jphacks/tkb_2618/docs/HANDOFF.md

# 引き継ぎ（2026-10-27 時点）

決めたこと・終わったこと・次にやることのまとめ。正はコード（main）で、ここと食い違ったらコードに合わせて直す。新しいセッションで作業を再開するときは、まずこれを読む。

## 進め方

- **Claude は PM と視覚の制作（UI デザイン、動画、図）の担当。** 仕様とタスク書を書き、単純な実装は Codex CLI に任せ、終わったら差分を確認する（ユーザー指示「あなたはPM 使うべきはcodex」「視覚などの創作タスク+PMはclaude 単純なコーディングはcodex」2026-10-26）
- Codex は `AGENTS.md` と `docs/tasks/NN-*.md` を読んで実装する
- コミット・プッシュは PM（Claude）がレビューしてから。ブランチは issue ごとに `main` から切り、`yub4-arema-<issue 番号>-<内容>` と名付ける（issue のない作業は `yub4-arema-<内容>`）。issue ごとのブランチは 2026-10-26 に決めた。main へのマージはユーザーが行う（リモート `jphacks/tkb_2618`）。**`jphacks/tkb_2628` は別チームのリポジトリなので触らない**
- ユーザーは質問を歓迎（「聞きたい内容があったらどんどん質問して」）。UI 文言は日本語
- 完成したら、ユーザーが元の Windows PC に移してハードをつないで確かめる。その手順の細部は PM に任されている → `docs/hardware-test.md`

## ハードで決まったこと（ユーザー決定、2026-10-24）

- 回路の正はチームの回路図 `docs/circuit.html`（元: https://claude.ai/artifact/SdUvAXonEdvWRYHbBbfajF ）。**回路は変えない。部品は買い足さない（購入済み）**
- XIAO ESP32S3、ピエゾ 7BB-27-4L0 ×4、NJU7043D ×2（ボルテージフォロワ）、ダイオードは小信号ショットキー **1SS106**
- ADC は D0 / D1 / D3 / D4（GPIO1 / 2 / 4 / 5）＝ 左上 / 右上 / 左下 / 右下。D2（GPIO3）はストラッピングピンなので使わない
- **本番のファームはチームの `firmware/xiao-stream/`**（2026-10-24 に remote の main へ入った）。判定はせず 4 ch の生値を毎秒 4000 行送るだけで、判定はアプリ（2026-10-24 のチームの決定）。`firmware/` のほかは参考実装。機能は変えない。xiao-stream は Arduino IDE で書き込み、PM は触らない
- アプリの判定は参考実装の `Detector` を TS に移したもの
- **任意のテーブルで成り立たせる**（特定の机・板に合わせ込まない）。テーブルごとの違いはキャリブレーション（ソフト）で吸収する

## いまの状態

| タスク | 状態 |
|---|---|
| 01 土台と画面 | ✅ PM が画面で確認済み（WSLg + CDP。寸法・角の線・端の点・光る演出・歯車パネル・ドラッグ・モックでのキャリブレーション完走） |
| 02 アクション・トレイ・通知 | ✅ 実装済み。Windows API は WSL で動かせないので、Windows での確認は `docs/hardware-test.md` 2 章 |
| 03 シリアル・キャリブレーション | ✅ 実装済み。Duplex テストで接続〜再接続を確認 |
| 04 ファームウェア | ✅ `pio run` / native テスト通過 |
| 05 hotkey を物理キーで記録（JIS） | ✅ `KeyboardEvent.code` で記録し、Set 1 スキャンコード（`KEYEVENTF_SCANCODE`）で送る。旧形式の移行、`npmRebuild: false`。test 14 件通過 |
| 06 XIAO 対応 | ✅ `xiao_esp32s3` env（USB CDC）。この書の回路の節は PM の誤りで、08 が正 |
| 07 任意のテーブル（プロトコル v1.1） | ✅ 学習した型での領域判定、`ring` → `refractoryMs`、飽和打の棄却。app test 21 件・native 30 件通過。モックでキャリブレーション完走・保存を画面で確認（飽和のモック打は数えない） |
| 08 ファームを正式な回路に合わせる | ✅ ピン 1/2/4/5、`raw` モード、`sat`（FW-007）、README を回路図どおりに。ビルド 3 env・native 27 件通過 |
| 10 本番ファーム xiao-stream に対応 | ✅ 検出器を TS に移植（`protocols/detector.ts`、参考実装の native テスト 24 件を同じ期待値で移植）。`xiao-stream` アダプタ（命令は手元で処理、校正値は `Config.calibration` に保存）、`protocol: 'auto'` で形式を自動判別。24 万行を 2〜3 バイトに割って流して 16 種類の tap と飽和を確認（約 0.3 秒）。test 59 件通過。`tests/fixtures/*.log` がルートの `*.log` で無視されて 09 のコミットに入っていなかったのも直した |
| 09 ファームの形式を差し替え可能に | ✅ シリアルの形式を `app/src/main/protocols/` のアダプタに分離（既定 `deskapi-v1`）。校正非対応のファームではボタンを無効化。ログを流し込むテスト、`npm run serial-log`。test 26 件通過 |
| 11 叩き方ごとの生値を集める CLI | ✅ `tools/tap-collect/collect.mjs`。叩き方を指示 → 開発者が叩く → ラベル付きで `raw.csv` / `trials.jsonl` に残す。（試行数と時間は 13 と 16 で変わった。今は `tools/tap-collect/README.md`）。`--mock`・`--resume`・違うファームの警告。PM が疑似端末で通しを確認 |
| 12 ログで検出器を採点する | ✅ `tools/tap-collect/score.mjs`。`app` と takker 版（`--takker <sensor-runtime>`）を同じ物差しで採点。キャリブレーション用と採点用のログを分ける（今は `--session` と `--calibrate A --test B`）。合成データの CV で app 87.5%・takker 43.8%（合成なので意味はない）。test 17 件通過 |
| 13 記録をキャリブレーション → 使用の 2 部に・5 分 | ✅ アプリと同じ手順のキャリブレーションの部（単打 8×3、2 回叩き 4×2）＋使用の部（16×3＋叩き以外 4）。自動で進む（`r` / Space / `n` / `q`）。（16 で強弱をなくし、今は 21 試行・約 2 分 17 秒）。採点は `--session` / `--calibrate A --test B`、`score.md` の先頭にキャリブレーションの診断。PM が疑似端末で確認。test 20 件通過 |
| 15 キャリブレーションの誤カウント・未接続ポップアップ | ✅ ユーザー指示で今回は Claude が実装（タスク書なし、`docs/spec.md` に反映）。**キャリブレーションを tools/tap-collect と同じ手順に作り替え**（指示 → 1 秒静止で基準値 → 合図 → 5 秒の区間だけ記録、静止のピーク × 1.5・50 ms の間で打を数える。自動では拾わない。`app/src/main/recorder.ts`）、強だけやり直し＋理由の表示、エラーを画面に出す、未接続ポップアップと理由（no-port / busy / no-response）、2 秒無通信で切断、**ポートを閉じずに `destroy()` していて再接続できなかったのを修正**、モックの校正値を保存しない。test 63 件通過。実機ログ（`tap-logs/20261025-015737`）を新しい数え方で再生すると各ステップ 0〜3 打しか拾えない＝信号が小さい（D1・D3・D4 の静止値が約 3250 で中点 1.65 V からずれている。テスターなし）。実機（COM5）で接続・ポート切り替え後の再接続・抜いたときのポップアップを確認 |
| 16 強弱の削除（8 キー） | ✅ 2026-10-25 のユーザー指示で Claude が実装（アプリ・デザイン・仕様）、tap-collect は Codex（`docs/tasks/16-no-strength-tap-collect.md`）。キー = 領域 × 1 回 / 2 回、`keyIndex = region*2 + count-1`。設定 `version: 2`、v1 は `upgradeConfig` で弱のキーを残して 8 キーに（弱が空なら強）。キャリブレーションは 4 段 × 3 打。しきい値は ch ごと（その ch が一番鳴った打の最小 × 0.5 と静止ピーク × 2 の大きい方）。山の係数 1.5 は実ログ 6 セッションで比較して据え置き（1.25 は誤検出が出る。4 ch のエネルギー合算も劣る）。参考ファームには `strongMin` 4095 をアダプタが補う。`DESKAPI_USER_DATA` で設定の置き場所を変えられる（モックのランダム打は本物のアクションを動かすため）。app test 65、tap-collect test 31＋skip 1。追記: 検出器の DC を最初の 1 サンプルで決めていたため、接続直後に途中で切れた行（3301 が 301 など）が来ると叩き続けの誤検出が止まらなかった（`tap-logs/20261025-045135`）。最初の 8 サンプルは判定せず、ずれた ch は中央値で置き直す。run モードで 2 秒しきい値を超え続けた ch は DC を置き直す。CLI の 2 回の指示を「ダブルタップ（トントンと素早く 2 回）」に（Codex）。指示を直したあとの 2 回叩きの間隔は 220〜340 ms で、待ち時間 320〜500 ms は点が同じなので 320 のまま。接触不良修理後のログ（`044350` で校正）: 完全一致 `045358` 75%、`044627` 37.5%、`045135` 25%。左下は校正で 3 打そろわないことが多い（センサーが遠い）|
| どの領域にも似ていない打を捨てる | ✅ 型があるとき、信頼度 0.3 未満の打はキーを動かさない（`detector.ts` の `MIN_CONFIDENCE`。実ログで領域違いは全部 0.3 未満、正解は 0.5 以上）。初期プロファイル「作業」をデモ用のアプリ起動 8 個に（デザインも同じ）|
| キャリブレーションの進め方（ユーザー決定 2026-10-25） | **tap-collect でキャリブレーションを最適化 → 本番（アプリ）に採用**。tap-collect の改修は Codex が行い、Claude は tap-collect に手を入れない。アプリの手順は collect.mjs に合わせる（指示から合図まで 2 秒、静止のピークは collect の定義）。採用する場所は `app/src/shared/tap-procedure.ts`（score.mjs の app アダプタが `main/recorder.ts` 経由で同じコードを採点に使う）。2 回叩きは最適化しない（ユーザー決定）ので、アプリのキャリブレーションに 2 回叩きのステップは入れない |
| 17 キーの色をスライドのパレットに | ✅ Codex が実装、PM が直した（PR #18。旧 id を `'gr' + 'een'` と分けて完了条件の検索をすり抜けていたのを、`validation.ts` の `RETIRED_COLORS` に）。test 70 件通過。キャリブレーションの波紋は、タイルの外へ広がるので白のまま |
| 審査の提出物（2026-10-26 08:00 締め切り） | ✅ README を初回コミットのテンプレートどおりに書き直し（項目 7 なし、精度の数字なし）。デモ動画と README 画像の Remotion ソースは `video/` に収録する（ユーザー許可 2026-10-26）。ロックファイル・ロゴ・使用中の 1080p 実機素材を含み、別 PC でも再生成できる。完成動画・未使用の元映像・node_modules は収録しない。手順は `video/README.md`。動画には発表動画と同じ説明（困りごと・仕組み）を入れず、実機の映像と設定画面を見せる（ユーザー決定 2026-10-26）。`demo.jpg` は実機の映像の 1.47 秒。タグ `hackday-code-freeze` = 42569d5。動画は YouTube に公開済み（https://youtu.be/Rw6g0IRwGyE）|
| 14 叩き以外の動作を増やす | 構想のみ（後回し）。PC を置く・マウス・ペンなど 11 種類と自分で足せる種類、叩き以外だけを撮るセッション（`--disturbances`、約 2 分半）、種類ごとの誤検出の採点。タスク書あり |

README（2026-10-27）: 精度の節は 2026-10-25 の採点（`044350` で校正、3 回分）の良い面を載せる。無線（Wi-Fi・BLE）は動いているが main にファームがないので、README では今後の展望に置く。

## 開発環境のメモ

新しい PC（Windows）での準備は `docs/setup.md`。2026-10-25 の時点で開発は Windows（実機は COM5）で直接行っている。`xiao-stream` の速度テストは、Windows では 1.1 秒かかって 1 秒の上限を超えることがある。以下は WSL で開発していたときのメモ。

- Codex は `codex exec -s workspace-write -C . "..." < /dev/null` で起動する（v0.163 には `--full-auto` がない。`< /dev/null` がないと stdin を待って止まることがある）。サンドボックスはネットワークなし → 依存は PM が先に `npm install` しておく
- firmware は `--add-dir /home/tsuch/.platformio` を付ける。`pio` は `uv tool install platformio` で `/home/tsuch/.local/bin/pio`、ツールチェーンはダウンロード済み
- npm がインストールスクリプトを止めるので、Electron 本体は `node node_modules/electron/install.js` で入れる
- 画面確認: `DISPLAY=:0 DESKAPI_MOCK=1 npx electron-vite dev --remoteDebuggingPort 9222` で起動し、CDP（`Page.captureScreenshot`、`Input.dispatchMouseEvent`）で撮影・操作する。WSL には日本語フォントがないので文字は豆腐になる
- `.orca/` はユーザーの資料置き場（領収書など個人情報を含む）。`.gitignore` 済み。コミットしない

## デザインで決まったこと（ユーザーの好み）

- 方向性は **フラットなミニマル（案 B 机マップ）**。影・グラデーション・木目やマットなどの質感は入れない。「AI slop」と言われた装飾的な案、ガラス案は不採用
- 文字は、アイコンだけでは分からないところにだけ付ける。例: アクション種別の選択肢には短いラベルを付けるが、割り当て後のキーには付けない。プロファイル名は文字。説明文・常識的な文言は書かない
- キーは Stream Deck アプリ風に、左上と右下に L 字の角の線（アイコン色、不透明度 60%）
- 机マップは領域ごとに横 2 キー（1 回 / 2 回）。上端に回数の点（1 個 / 2 個）。文字ラベルはない
- キーの色は発表スライドと同じパレット: 赤 #D12052、橙 #F45B26、黄 #F8DE22、水色 #03AED2、紺 #3C3781。紺以外の上ではアイコンを黒 #121212 にする（2026-10-26 に Adobe Color のパレットから変更。保存済みの旧 id `green` / `blue` は読み込み時に `orange` / `cyan` に直す）
- 背景 #121212、右パネル #1A1A1A
- 設定画面が開いているときは、叩かれたキーを光らせる。閉じているときは Windows 通知
- ドラッグでキーの入れ替えとアクションの割り当て
- メイン UI にシミュレータは入れない。開発者用のデバッグ / ログツールはあとで別画面として作る
- キャリブレーション画面のガラス風装飾はユーザーが「まだ」と保留

デザインの作業キャンバス（全案入り）: https://claude.ai/artifact/63JDGGvWX3fVYajsQuNvty

## 技術の前提

- Windows 専用。Electron + electron-vite + React 19 + Tailwind v4 + @dnd-kit/core。キー入力は koffi（user32 `SendInput`）、マイクは常駐 PowerShell（Core Audio）、シリアルは serialport
- `koffi` と `serialport` は OS ごとに別バイナリ。Windows では必ず `npm ci` し直す（`node_modules` をコピーしない）
- Notion は使わない

## 仕様で PM が決め、コードに入っていること

- ウィンドウを閉じているときは、発火のたびに Windows 通知を出す（歯車パネルでオフにできる）
- ロック中は、ロックアクションのキーだけ反応する（タップで解除できるように）
- 歯車パネルは「通知」「自動起動」「ポート」の 3 項目
- 飽和した打（FW-007、±1.4 V 超え）はアプリが無視する（アクションを実行しない、キャリブレーションで数えない）
- 任意のテーブル対応として、領域判定をキャリブレーションで学んだ型（4 ch の出方）で行い、余韻の長さから `refractoryMs` を決める（protocol v1.1）
- Windows のモック（`DESKAPI_MOCK=1`）は 4 秒ごとにアクションを本当に実行するので、実機確認ではテスト実行ボタンを使う
