jphacks/tkb_2618/docs/tasks/13-calibration-phase.md

# 13 記録をアプリと同じ「キャリブレーション → 使用」の 2 部にする

`tools/tap-collect/` だけ。`app/` と `firmware/` には触らない。

## 背景

11 / 12 では、シャッフルして叩いた試行の一部をキャリブレーションの代わりに使っていた。実際のアプリは「キャリブレーション画面で 1 種類ずつまとめて叩く → その結果で基準を決める → 使う」なので、これでは**キャリブレーションの仕組みそのものに問題がないか**を確かめられない。

そこで 1 セッションを、アプリと同じ 2 部に分ける。

1. **キャリブレーションの部**: アプリのキャリブレーション画面と同じ手順で叩く
2. **使用の部**: いまと同じ、16 パターンと叩き以外をシャッフルして叩く

採点は「1 だけでキャリブレーション → 2 だけで採点」にする。点数が悪いとき、キャリブレーションの段階で失敗したのか、使う段階で外れたのかを分けて見られるようにする。

デモで使う机は決まっているので、同じ机で何度も記録して調整する使い方が主になる。

**1 セッションは合計 5 分以内**（ユーザー指定）。長い 1 回より、5 分のセッションを何度も撮って合算する（採点は複数セッションを合算できる）。

## 時間の配分（既定）

| 部 | 中身 | 時間 |
|---|---|---|
| キャリブレーション | 静止（待ち 2 秒 ＋ 3 秒）＋ 1 回叩き 8 区間 × 7 秒 ＋ 2 回叩き 4 区間 × 7 秒 | 1 分 29 秒 |
| 使用 | 16 パターン × 1 回 × 7 秒 ＋ 叩き以外 4 試行 × 5 秒 | 2 分 12 秒 |
| 合計 | | **3 分 41 秒（33 試行）** |

そのために、試行の進め方を変える。

- **Enter を待たずに自動で次へ進む**。区間が終わったら結果を 1 行で出し（ch ごとの最大のずれ。確認用の山の数は校正用の打撃記録だけ）、すぐに次の指示を出す
- 次の指示を出してから合図まで 2 秒（そのうち合図前 1 秒が記録範囲＝基準値の区間）。`--prepare` で 1 秒以上に変更可能。カウントダウンは出さず、`[14/33] 次: 右上 2回 強` → `叩いて` の 2 段にする。合図は各試行で 1 回だけ表示し、進捗行に合図・指示を重複させない
- 使用の部の区間は 5 秒（3 回叩きは 6 秒）。校正用の打撃区間も 5 秒。叩き以外は 3 秒
- キー（どのタイミングでも効く）:
  - `r`: 直前に終わった試行を `redo` にして、次に撮り直す（記録中に押したら、いま記録中の試行を `redo` にして撮り直す）
  - `n`: 直前の試行にメモを付ける（入力中は一時停止）
  - `Space`: 一時停止 / 再開（手を休めるとき。一時停止中の試行は `aborted` にして、再開後に撮り直す）
  - `q` / Ctrl+C: 終了（いまと同じく保存して終わる。`--resume` で続きから）
- `--reps` の既定を 1 に、叩き以外は各 1 回に、`--window` の既定を 5 秒にする。`--resume` は元の試行と時間を引き継ぐ（`prepare` がない旧セッションは待ち 1.5 秒）
- 終わったら、かかった時間を出す

## 1. tap-collect: キャリブレーションの部

セッションの最初に、次の順で撮る（シャッフルしない。`--order` は使用の部にだけ効く）。

| 順 | kind | 指示 | 長さ |
|---|---|---|---|
| 1 | `calibration` | 机に触れず静止する（いまと同じ） | 3 秒 |
| 2〜9 | `cal_single` | 「左上・弱 を 3 回、ゆっくり叩く」。左上弱 → 左上強 → 右上弱 → 右上強 → 左下弱 → 左下強 → 右下弱 → 右下強（アプリのキャリブレーション画面と同じ順） | 5 秒 |
| 10〜13 | `cal_double` | 「左上 を 2 回叩きで 2 セット」。左上 → 右上 → 左下 → 右下。強さは問わない（2 回叩きの間隔を測るためなので） | 5 秒 |

- `--strengths` / `--zones` に合わせて、出てこない領域・強さは撮らない（`medium` を足したら `cal_single` にも入る）。`--counts` に 2 がなければ `cal_double` は撮らない。3 回叩きは使用の部だけ
- 記録中の表示・キー・ファイルへの残し方は、使用の部と同じ。`trials.jsonl` には `phase: "calibration"`、`zone`、`strength`（`cal_double` は `null`）、`count`（`cal_single` は 1、`cal_double` は 2）、`sets`（`cal_single` は 3、`cal_double` は 2）を入れる
- 撮り終えたら、その場で「ch ごとの最大のずれ」を出す。校正用の打撃記録（`cal_single` / `cal_double`）では、合図前 1 秒の中央値からのずれが ch ごとの「静止」の最大のずれ × 1.5 を超えた波を `山 3` のように出し、その場で打撃を拾えているか確認できるようにする。波は 50 ms を超える静かな間隔で区切る。静止の測定・使用の部では山を判定・表示しない。この数え方は確認表示のためだけで、検出器の校正・採点には使わない。使用の部は後から `score.mjs` で校正済みの検出器に流して採点する。旧ログ（× 3）とは直接比較しない。
- 使用の部の試行は `phase: "use"`。いまの試行と同じ
- `README.md`（ログの形式の説明）に、2 部構成と新しい項目を書き足す

### 合成データ（`--mock`）

`cal_single` は合図の 0.4 秒後から約 1.4 秒（±0.3 秒）おきに 3 回、`cal_double` は約 2.2 秒おきに 2 回叩きを 2 セット。1 回ずつの振幅・重みのばらつきは 12 の修正と同じ。

## 2. 採点: キャリブレーションの部でキャリブレーションし、使用の部で採点する

```
node score.mjs --detector app --session tap-logs/A                     # A のキャリブレーションの部 → A の使用の部
node score.mjs --detector app --calibrate tap-logs/A --test tap-logs/B  # A のキャリブレーションの部 → B の使用の部
```

- `--session <dir>…`: セッションごとに、そのセッションのキャリブレーションの部でキャリブレーションし、同じセッションの使用の部で採点する。複数なら合算する
- `--calibrate <dir> --test <dir>…`: センサーを貼り直したあとのログなどで確かめるため
- `--cv` と `--train` はなくす（キャリブレーションの部があるので要らない）。キャリブレーションの部がないログを渡したら、そう分かるエラーにする

### 検出器のキャリブレーション

- `app`: `calibration` でノイズを測り、校正用の打撃を探すしきい値を記録した静止ピーク × 1.5（最低 1）にする（固定 150 は使わない）。アプリの記録処理（`recorder.ts` の `MountainCounter`）で `cal_single` の各区間の合図前の中央値を基準に `hit` を集め、設定画面と同じく飽和していない山のうち振幅が大きいものから領域×強さごとに 3 つずつ `calculateCalibration` に渡す。3 つに足りなければ、どれが何個だったかを書いて 0 点。使用の部は計算した校正値で `Detector` に流して判定する。校正用のしきい値は `calibrationThresholds` に保存する
- `takker`: `cal_single` の区間で出た `tap` から `features` を作り、`TARGETS` ごとに `REQUIRED` 個。足りなければ同様
- `cal_double` は、どちらの検出器のキャリブレーションにもいまは使わない（検出器の作りを変えないため）。代わりに下の「キャリブレーションの部の診断」で測る

### キャリブレーションの部の診断（`score.md` の最初の表）

キャリブレーションの仕組みに問題がないかを見るための表。採点の点数より前に出す。

| 項目 | 中身 |
|---|---|
| 区間ごとの検出数 | `cal_single` / `cal_double` の区間ごとに、検出器が見つけた打（`app` は `hit`、`takker` は `tap`）の数。期待は `cal_single` 3、`cal_double` 4。ずれている区間に印 |
| 飽和 | 飽和で数えなかった打の数 |
| キャリブレーションの結果 | 決まった値（`app` は閾値・強弱の境目・型・`refractoryMs`・`doubleWindowMs`、`takker` は覚えた特徴の中心とばらつき） |
| 強弱の分かれ方 | 領域ごとに、弱 3 回と強 3 回の振幅の最小〜最大。重なっていたら印 |
| 2 回叩きの間隔 | `cal_double` で測った 1 回目と 2 回目の間隔（ms）の最小・平均・最大と、検出器の 2 回目の待ち時間（`app` の `doubleWindowMs`、`takker` の `doubleMs`）。最大が待ち時間を超えていたら印 |

そのあとに、いまと同じ使用の部の点数（完全一致・強さを無視した一致・領域 / 回数 / 強さ・余計・叩き以外・試行外・混同行列）を出す。

## テスト

- 11 / 12 のテストを 2 部構成に合わせて直す
- 並び: キャリブレーションの部が先頭に固定の順で並び、`--seed` は使用の部の並びだけを変える。既定で 1 + 8 + 4 + 16 + 4 = 33 試行
- 時間: 既定の並びで、記録の区間と合図までの間の合計が 5 分以内（操作の待ちは含めない計算で、時計を差し替えて確かめる）
- 自動で進む: キー入力なしで最後まで進む。`r`（直前・記録中）、`Space`（一時停止 → `aborted` → 撮り直し）、`n` が仕様どおり
- 診断: 合成の打の一覧から、区間ごとの検出数・強弱の重なり・2 回叩きの間隔が期待どおり数えられる
- `--mock` 相当のセッションで `--session` の採点が `app` と `takker` の両方で 0 点より大きい（takker は `TAKKER_RUNTIME` があるときだけ）
- キャリブレーションの部がないログでエラー

## 完了条件

- `npm test`、`TAKKER_RUNTIME=/tmp/takker-runtime/mockui/sensor-runtime npm test` が通る
- 完了報告に、`--mock` 相当のセッションでの `app` / `takker` の `score.md` の 1 行目と、診断の表の例
- `docs/hardware-test.md` の tap-collect の節を 2 部構成・自動で進む形に合わせて直す（1 セッション約 5 分、何度も撮って `--session A B C` で合算すること）
- 完了報告に、既定の 1 セッションの計算上の所要時間と `raw.csv` の大きさ

## PM レビューでの修正

1. **キーボードを打つ試行で、打ったキーが操作になる**: `typing` の記録中に打った `q` / `r` / Space / `n` が、終了・撮り直し・一時停止・メモとして効いてしまう。キーボードを使う試行（いまは `typing`。今後キーボードやマウスを使う種類が増える）の**記録中は、Ctrl+C 以外のキーをすべて無視する**（`events.jsonl` に `key` としては残さない。打った内容を残さないため）。その試行の指示文に「（このウィンドウで打って大丈夫）」を足す。記録が終わったら、いつもどおりキーが効く。テストを足す
