jphacks/tkb_2618/(commit log)

2026-10-24 Add xiao-stream firmware (XIAO ESP32S3, 4ch ADC streaming)
2026-10-25 yub4-aremaのコードを採用した (#1)
    * DeskAPI: 仕様・デザイン・Codex タスク書と実装の途中経過
    - AGENTS.md, docs/spec.md, docs/protocol.md, docs/tasks/01-04
    - docs/design: 承認済みの設定画面・キャリブレーション画面
    - app/: Electron + React の土台と画面（タスク 01 途中、メモリ不足で中断）
    - firmware/: ESP32 ファームウェア（タスク 04 途中、メモリ不足で中断）
    * 引き継ぎ資料（docs/HANDOFF.md）と CLAUDE.md を追加
    * DeskAPI: アプリ・ファームを実機確認できる状態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
2026-10-25 キーの色を発表スライドのパレットにそろえる (#18)
    * キーの色を発表スライドのパレットにそろえる
    赤 #D12052、橙 #F45B26、黄 #F8DE22、水色 #03AED2、紺 #3C3781 の 5 色にする。
    紺以外の上ではアイコンを黒にする。画面のアクセント色（ロック・エラー・
    キャリブレーションの叩く領域・トグル）も同じパレットの色にする。
    色の id は green → orange、blue → cyan に変え、保存済みの設定は読み込み時に
    新しい id に直す。
    * キャリブレーションの波紋を白に戻す
    波紋はタイルの外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
2026-10-25 README を実装に合わせて書き直す (#20)
    * README を実装に合わせて書き直す
    初回コミットのテンプレートの見出しに沿って、製品の説明・仕組み・操作の種類・
    使った技術・独自技術を、いまの実装のとおりに書く。画像はデモ動画と同じ場面から
    書き出したもの。
    * README から動画のソースの記述を外し、Webhook の説明を実装に合わせる
    デモ動画のソースは作品の本体ではないので、リポジトリに入れない。
    Webhook が送るのは叩いた場所・回数・時刻の JSON で、Slack の形式では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
2026-10-25 引き継ぎ書類を更新する (#21)
    * 役割分担に、視覚の制作は Claude が行うことを書く
    UI デザイン・動画・図は Claude が作り、Codex には単純な実装を渡す。
    * 引き継ぎに、審査の提出物とデモ動画の作り直し方を書く
    README・動画・画像の状態と、ユーザーが YouTube の URL を差し替えること。
    動画を作り直すときの依存と、Git に入れていない実機の映像の置き方。
    * ブランチを issue ごとに main から切ることを引き継ぎに書く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
2026-10-26 Remotion の動画ソースと再生成手順を収録 (#22)
2026-10-26 README に精度・既存製品との違い・設計の理由を追記し、docs をコードに合わせる (#23)
    * README に精度・既存製品との違い・設計の理由を追記し、docs をコードに合わせる
    - README: 精度（2026-10-25 の採点）、Knocki との違い、判定を PC で行う理由、生の値を送る理由、強弱をやめた理由を追記。展望に無線の送信量を追記
    - AGENTS.md: 正はコードで、食い違ったら docs を直すこと、決まったことには日付を添えることを追記
    - spec.md / protocol.md / HANDOFF.md: 設定の型（version 2、8 キー）、飽和と信頼度の扱い、tap-collect の今の試行数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
